MIRYHANG/srm-2027-minibot/README.md

# srm-2027-minibot

2027 校内赛抓取小车的控制程序。仓库里有两个工程：

- **小车主控**（仓库根目录）：STM32G474VET6，STM32Cube HAL、FreeRTOS（CMSIS-RTOS v1）、CMake
- **NRF24 手柄**（`Handheld/`）：STM32F103RC，裸机循环

两边共用的无线收发和手柄数据包代码放在 `Common/`。

以下内容按 2026-11-02 的 `power-on-debug` 分支整理。

## 当前进度

| 部分 | 状态 |
|---|---|
| 整车 | 2026-10-31 装上机械臂后整车联调通过，能正常行驶和操作机械臂 |
| 手柄 → NRF24 → 小车链路 | 实车联通：使能、换挡、摇杆、自转键都能控制小车 |
| 底盘四轮速度闭环 | 实车调过 PI 参数，四轮正常运行；行驶方向已按实车修正 |
| 机械臂 | 能用手柄点动；6 个舵机中 1 个烧毁，现有 5 个可用；预设姿态的角度是装机前的占位值，还没在实物上测量；关节零位、方向和限位还没标定 |
| 手机蓝牙遥控 | 代码保留，可编译切换，当前不用 |
| 电池电压、OLED 显示 | INA226 采样、欠压保护、OLED 显示已接入 |
| BMI088 姿态测量 | 已从板上拆下，驱动和航向保持代码已删除 |
| 电脑端单元测试 | 小车 17 组、手柄 1 组，全部通过 |

## 目录结构

| 目录 | 内容 |
|---|---|
| `Core/` | CubeMX 生成的启动、时钟、外设初始化；`app_freertos.c` 创建任务并把各模块串起来 |
| `BSP/` | 硬件封装：电机 PWM 与方向、编码器、舵机、INA226、SSD1306 OLED、I2C 总线、急停 |
| `Algorithm/` | 与硬件无关的计算：麦轮解算、PID |
| `Application/` | 整车逻辑：遥控输入与来源切换、使能和换挡、底盘指令换算、机械臂控制、电池监测、安全输入、任务心跳 |
| `Protocol/` | 手机蓝牙用的 SRM 串口协议：组帧、CRC、解码 |
| `Common/` | 小车和手柄共用：NRF24 驱动和链路层、手柄数据包 |
| `Handheld/` | 手柄工程，结构与小车相同（`Core/`、`Application/`、`Test/`） |
| `Test/` | 小车的电脑端单元测试 |
| `tools/` | 辅助脚本，目前有一键运行全部单元测试的脚本 |
| `docs/` | 架构说明、机械臂调用关系、调试日志 |
| `bringup/` | 早期单独验证 OLED 和电机用的小工程，不参与正式固件 |

## 小车软件结构

### 任务

| 任务 | 周期 | 优先级 | 职责 |
|---|---|---|---|
| `ProtocolTask` | 5 ms | AboveNormal | 收手柄和手机数据，读急停和欠压，处理使能和换挡，发布最新命令，回传状态给手柄 |
| `ChassisControlTask` | 10 ms | High | 麦轮解算、编码器测速、四轮速度 PI、输出 PWM；检查各任务心跳并喂看门狗 |
| `ArmTask` | 20 ms | Normal | 按命令点动或切换预设，限速逼近目标，换算成 6 路舵机脉宽 |
| `SensorTask` | 100 ms | Low | 读 INA226 电压电流、电池电量判断、刷新 OLED |

### 数据链路

```text
手柄摇杆和按键（每 10 ms 发一包，NRF24 2.500 GHz）
  → 小车 NRF24 接收，校验数据包
  → RemoteInput：选定遥控来源，超时 100 ms 判掉线
  → SafetyInput：急停、欠压
  → RobotCmd：使能锁存、换挡，生成底盘命令和机械臂命令
  ├→ ChassisDrive：按挡位换算四轮目标转速 → 编码器测速 → 速度 PI → TIM1 PWM 和方向引脚
  └→ ArmCycle：点动或预设 → 限位、限速 → 舵机脉宽 → TIM8 / TIM15
```

遥控来源在编译时选择：`Core/Src/app_freertos.c` 里的 `REMOTE_ACTIVE_SOURCE`，当前是 `REMOTE_SOURCE_HANDHELD`。改成 `REMOTE_SOURCE_PHONE` 就用手机蓝牙（USART2，9600 波特率，超时 200 ms）。

### 安全机制

- **使能要先失能再使能**：上电、急停解除或掉线恢复后，必须先收到一次"未使能"，再收到"使能"，小车才会动，防止手柄一直锁在使能状态时车自己跑起来。
- **掉线停车**：手柄超过 100 ms 没有有效数据包，底盘目标清零、PID 清零、PWM 归零；机械臂停在当前位置但保持出力。
- **硬件急停**：PE10 为低时整车失能。急停线同时接在四个驱动芯片的 nSLEEP 上，按下时驱动直接关断输出。
- **欠压保护**：3S 电池，单节低于 3.50 V（共 10.5 V）报警，低于 3.30 V（共 9.9 V）停车，带 0.1 V/节回差和 2 s 确认时间。
- **任务心跳和看门狗**：底盘任务确认其他三个任务都按时打了心跳才喂 IWDG，超时约 100 ms 整机复位。调试暂停时 IWDG 和 TIM1 冻结。
- **异常停机**：HardFault、`Error_Handler`、断言失败、栈溢出、内存分配失败都会直接关掉四路电机 PWM。
- **复位记录**：`g_reset_stats` 放在不初始化的 `.noinit` 段，按原因（引脚、欠压/上电、看门狗、软件）累计复位次数，在 Ozone 里能看到。

## 手柄操作

| 按键 | 作用 |
|---|---|
| START | 使能小车；同时把机械臂方向复位成正向、解除机械臂停止 |
| ESTOP | 失能小车，按下立刻生效 |
| 摇杆 | 前后、左右平移 |
| 摇杆按下 | 换挡 1 → 2 → 3 → 1，每次使能回到 1 挡 |
| CCW / CW | 按住时逆时针 / 顺时针自转 |
| J1～J5、GRIPPER | 按住时对应关节按当前方向点动 |
| ARM_DIR | 单按切换点动方向；按住时再按 J1 回收起姿态，按 J2 进入抓取准备姿态 |
| ARM_STOP | 只停机械臂，按 START 解除 |

解锁顺序：按一下 ESTOP 松开，再按 START。

| 指示灯 | 含义 |
|---|---|
| LED1 灭 / 慢闪 / 常亮 / 快闪 | 断连 / 已连上未使能 / 已使能 / 小车急停或驱动故障 |
| LED2 灭 / 常亮 / 快闪 | 机械臂正向 / 反向 / 已停止 |
| 两灯同时快闪 | 摇杆没标定好（上电时摇杆被推着）或 ADC 异常，手柄强制失能 |

## 硬件接口

### 小车主控

| 功能 | 外设 / 引脚 |
|---|---|
| 四路电机 PWM（20 kHz） | TIM1 CH1～CH4：FL PC0、FR PC1、RL PC2、RR PC3 |
| 四路电机方向 | FL PE2、FR PE3、RL PE4、RR PE5 |
| 四路驱动故障 nFAULT | FL PE12、FR PE13、RL PE14、RR PE15 |
| 编码器 | FL TIM4（PD12/PD13）、FR TIM3（PA6/PA4）、RL TIM2（PD3/PD4）、RR TIM5（PA0/PA1） |
| 六路舵机（50 Hz） | TIM8 CH1～CH4：PC6～PC9；TIM15 CH1/CH2：PB14、PB15 |
| NRF24 | SPI1：PB3 SCK、PB4 MISO、PB5 MOSI；PA10 CSN、PA11 CE、PE0 IRQ |
| 手机蓝牙 | USART2：PA2 TX、PA3 RX |
| OLED 和 INA226 | I2C2：PA8 SDA、PA9 SCL |
| 急停 | PE10，低电平有效 |
| 状态灯 | PE7 运行（500 ms 翻转）、PE8 已使能、PE9 安全故障 |
| 调试 | SWD：PA13、PA14 |

电机驱动为 DRV8873H，PH/EN 模式。BMI088 的片选和中断引脚在 CubeMX 里还保留着，没有使用。

### 手柄

| 功能 | 引脚 |
|---|---|
| 摇杆 X / Y | PA1 / PA2（ADC） |
| 摇杆按下 | PA9 |
| START / ESTOP | PC8 / PC9 |
| CCW / CW | PC6 / PC7 |
| ARM_DIR / ARM_STOP | PB0 / PB1 |
| J1～J5、GRIPPER | PB10～PB15 |
| LED1 / LED2 | PB7 / PB6 |
| NRF24 | SPI1：PA5 SCK、PA6 MISO、PA7 MOSI；PA4 CSN、PA8 CE、PB8 IRQ |

## 实车参数

| 参数 | 值 | 位置 |
|---|---|---|
| 编码器每圈计数 | 1321（输出轴，实测） | `BSP/encoder.h` |
| 编码器方向 | FL -1、FR 1、RL 1、RR -1 | `BSP/encoder.h` |
| 电机方向 | FL 1、FR -1、RL -1、RR 1 | `Core/Src/app_freertos.c`，`Motor_InitAndStart` |
| 速度 PI | FL、FR：Kp 0.016、Ki 0.04；RL、RR：Kp 0.02、Ki 0.04；输出限幅 1.0 | `Core/Src/app_freertos.c`，`SpeedPID_InitAll` |
| 挡位最大轮速 | 200 / 250 / 300 rpm | `Application/chassis_drive.h` |
| 关节限位 | J1～J5 均为 0～180°，对应 500～2500 µs | `Application/arm_calib.c` |
| 夹爪 | 0（张开）～1（闭合），对应 1000～2000 µs | `Application/arm_calib.c` |
| 关节点动速度 | 60°/s，夹爪 0.5/s | `Application/arm_calib.c` |
| 收起姿态（上电位置） | J1～J5：90、30、30、90、90°，夹爪张开（占位值，未实测） | `Application/arm_control.c` |
| 抓取准备姿态 | J1～J5：90、60、120、135、90°，夹爪张开（占位值，未实测） | `Application/arm_control.c` |
| NRF24 信道 | 100（2.500 GHz） | `Common/NRF24/nrf_link.h` |

## 临时措施与已知问题

以下是为了先让车动起来而做的临时处理，硬件改好后要恢复。

1. **驱动故障检测被屏蔽。** DRV8873H 的 nOL 引脚接了地，会打开运行中的开路检测；电机电流或占空比小时会误报并锁住 nFAULT，但 H 桥照常输出。误报会让整车失能，所以 `MOTOR_FAULT_IGNORE_MASK` 暂时屏蔽了四路 nFAULT。过流和过热仍由驱动芯片自己关断。
   - 硬件改法：四个驱动的 nOL 改接 DVDD。
   - 改好后把 `MOTOR_FAULT_IGNORE_MASK` 改回 `0U`。
2. **机械臂限位暂时放开到 0～180°**，方便实物标定。标定出各关节真实的机械范围后要收回来，否则可能顶坏结构。
3. **驱动芯片损坏过**：10-30 FL 驱动芯片损坏，FL 电机不受控狂转，已更换新芯片，现在四轮正常。调试中 RR 也出现过程序没运行时电机自转的现象。驱动先后出问题，可能是电机刹车时反电动势把 VM 冲高，建议每个驱动旁加 100～470 µF 电解电容。
4. **舵机堵转导致复位和烧毁**：10-31 六个舵机一起上电，几个舵机堵转把主控拉复位，一个舵机烧毁。更换全部降压电路后恢复正常。
   - 原因：上电时 6 个舵机会同时全速转到收起姿态。这组角度是装机前填的占位值，可能让机械臂顶到结构上而堵转。
   - 建议：先在实物上量出收起姿态的角度，写进代码；舵机单独用一路大电流降压供电，并在舵机电源上加大电容。
5. **接 J-Link 时会复位**：Ozone 下载、复位或两个程序同时连 J-Link 都会让主控复位；装上机械臂后，J-Link 接着一段时间也会复位（J-Link 没有接 3.3V）。拔掉 J-Link 后实测 5 分钟没有复位。因为这个问题，预设姿态还没法在 Ozone 里看着舵机角度实测。
   - 复位脚现在飞线接到了 3.3V。如果中间没有串电阻，按复位键会直接把 3.3V 对地短路，看门狗和 J-Link 也拉不低复位脚。建议改成 10 kΩ 上拉到 3.3V，再并 100 nF 电容到地。
6. **电机噪声**：速度环每 10 ms 测一次速，多数或少数一个编码器计数，测出的转速就差约 4.5 rpm，速度环输出会小幅来回跳动。可以加大测速滤波或给误差加死区，还没改。

## 构建、烧录和测试

需要 `arm-none-eabi-gcc`、CMake、Ninja；测试需要电脑上的 `gcc`。

```bash
# 小车固件，产物 build/Debug/XiaoSai.elf
cmake --preset Debug
cmake --build build/Debug

# 手柄固件，产物 Handheld/build/Debug/XiaoSai_NRF.elf
cd Handheld
cmake --preset Debug
cmake --build build/Debug

# 电脑端单元测试（仓库根目录运行）
bash tools/run_host_tests.sh
```

烧录和调试用 J-Link + SEGGER Ozone，直接打开 `XiaoSai.jdebug`（小车）或 `Handheld/XiaoSai_NRF.jdebug`（手柄）。工程里预置了常用观察变量，按 10 Hz 实时刷新。这个 J-Link 不支持高速采样，Data Sampling 用不了，看波形要用 Watched Data。

修改引脚、定时器等外设配置时，以 `XiaoSai.ioc` / `Handheld/XiaoSai_NRF.ioc` 为准，用 CubeMX 重新生成；自己写的代码放在 USER CODE 区或独立模块里。

## 文档

| 文档 | 内容 |
|---|---|
| `docs/小车工程架构说明.md` | 2026-10-03 时的整体架构，部分内容已过时，以本 README 为准 |
| `docs/机械臂代码调用关系.md` | 机械臂各模块的调用关系、数据结构和安全机制 |
| `docs/调试日志.md` | 电脑端测试和固件构建记录 |
| `docs/上电调试日志.md` | 实车上电调试记录 |
| `RM校内赛机械臂设计手册.docx` | 结构组给出的机械臂设计手册 |

## 历史开发记录

以下保留当时的记录，内容已过时，最新状态以上文为准。完整修改过程见 `git log`。

### 2026-09-28

#### 今日完成

以下条目表示代码或配置已实现，不代表已经通过硬件验证

- [x] 完成当前引脚调整：SPI1 使用 PB3/PB4/PB5，I2C 从 I2C1 切换为 I2C2，使用 PA8 SDA 和 PA9 SCL
- [x] 将 BMI088 加速度计、陀螺仪片选移至 PC10、PC11，并将初始电平设为 High
- [x] 配置六路舵机 PWM：TIM8 的 PC6～PC9，以及 TIM15 的 PB14/PB15，当前频率为 50 Hz
- [x] 开启 USART2 中断，抢占优先级设为 5，与当前 FreeRTOS 中断 API 使用要求匹配
- [x] 实现 `RemotePhone_ProcessByte()`：逐字节组帧、CRC 校验、CONTROL 解码、命令转换和手机状态更新
- [x] 实现 `remote_uart` 接收模块：创建队列、启动单字节中断接收、保存接收时间、入队和非阻塞出队
- [x] 实现接收异常标记、错误回调及任务侧恢复，恢复时停止接收、丢弃缓存并重新启动
- [x] 实现 `PhoneRemote_InitAndStart()` 和 `PhoneRemote_Update()`，接入现有底盘周期任务
- [x] 实现 `Chassis_UpdateFromRemote()`，将归一化遥控量转换为底盘速度，再计算四轮目标 RPM

#### 当前数据链路

```text
USART2 接收一个字节
  → 中断回调将字节和接收时间放入队列
  → 底盘任务按处理预算取出字节
  → RemotePhone_ProcessByte 拼帧、校验、解码和转换
  → RemoteInput 保存手机命令和有效帧时间
  → RemoteInput_GetSafe 检查来源、超时、使能和停机请求
  → Chassis_UpdateFromRemote 换算底盘速度
  → 麦轮解算得到四轮目标 RPM
  → 编码器测速与 PID 计算
```

- 中断只接收和暂存数据，协议解析与遥控状态修改由同一个底盘任务完成
- 队列容量为 64 个接收记录，每个记录包含一个字节和毫秒时间戳
- 每个任务周期最多处理 64 个字节，不是 64 帧
- 时间戳使用字节接收回调中的 `HAL_GetTick()`，不是任务稍后处理字节的时间
- 只有完整有效的控制帧才会更新 `last_valid_ms`
- 掉线、未使能、停机请求或接收异常时，当前安全遥控命令归零
- 接收异常时清空手机旧状态并重置解析器，恢复后必须等待新的有效帧

#### 当前运行限制

- 底盘任务周期为 10 个 RTOS tick，当前 tick 频率为 1000 Hz，对应约 10 ms
- 底盘尺寸、速度上限和 PID 增益仍为零占位，不产生正常运动目标
- `WheelSpeed_Update()` 目前只计算 PID，尚未将输出交给 `Motor_SetOutput()`
- `Chassis_Stop()` 尚未实现，目标 RPM 归零不能代替实际 PWM 停机与 PID 状态清理
- 手机无线串口模块到小车的真实链路、四轮闭环及六路舵机均未完成实物联调
- 今日新增接收与任务链路尚未记录编译、上板运行及异常注入测试结果

#### 当前主要引脚

以当前 `XiaoSai.ioc` 配置为准，轮位标签与程序实例绑定仍需核对

| 功能 | 外设 / 引脚 |
|---|---|
| 四路电机 PWM | TIM1 CH1～CH4：PC0、PC1、PC2、PC3 |
| 四路电机方向 | FL/FR/RL/RR：PE2、PE3、PE4、PE5 |
| 编码器 TIM2 | PD3、PD4 |
| 编码器 TIM3 | PA6、PA4 |
| 编码器 TIM4 | PD12、PD13 |
| 编码器 TIM5 | PA0、PA1 |
| 六路舵机 PWM | TIM8：PC6～PC9；TIM15：PB14、PB15 |
| SPI1 | PB3 SCK、PB4 MISO、PB5 MOSI |
| BMI088 片选 | PC10 ACC_CS、PC11 GYRO_CS，初始 High |
| NRF24 控制 | PA10 CSN，初始 High；PA11 CE，初始 Low |
| I2C2 | PA8 SDA、PA9 SCL |
| USART2 | PA2 TX、PA3 RX |
| SWD | PA13、PA14 |

#### 参数待办

| 参数 | 当前设置 | 待确认事项 |
|---|---|---|
| 轮半径、轴距、轮距 | 均为 `0.0f` | 实测并填写，单位为米 |
| 编码器每圈计数 | `COUNT_PER_REV = 10` | 确认输出轴每圈实际定时器计数，包含编码器倍频和减速比影响 |
| 编码器方向 | 四轮统一使用 `DIRECTION_SIGN = -1` | 根据轮位和接线逐轮验证 |
| 电机方向 | 四轮初始化均为 `+1` | 逐轮确认正转与编码器正方向一致 |
| 测速滤波时间常数 | `0.01 s` | 根据测速噪声与响应调整 |
| PID 增益 | `Kp/Ki/Kd` 均为零 | 上板后逐轮调试，当前输出限幅为 `1.0` |
| 前后 / 横移速度上限 | 均为 `0.0 m/s` | 根据底盘能力设置保守上限并验证 |
| 旋转角速度上限 | `0.0 rad/s` | 根据底盘能力设置并验证 |
| 手机遥控超时 | `200 ms` | 根据实际发送周期和链路延迟确认 |
| USART2 波特率 | `9600` | 与手机无线串口模块的串口侧配置一致 |
| 舵机控制参数 | 仅配置 50 Hz PWM | 确认舵机型号、脉宽范围、零位、角度限位及动作速度 |
| 电源监测参数 | 尚未实现 | 确认分流电阻、INA226 校准、电池容量及保护阈值 |

#### 后续任务

- [ ] 核对编码器轮位标签与程序绑定：当前 IOC 的 FL 标签在 TIM4、RL 标签在 TIM2，但 `Encoder_InitAndStart()` 将 FL 绑定到 TIM2、RL 绑定到 TIM4，需按实际接线统一
- [ ] 实现 `Chassis_Stop()`：四轮目标归零、PWM 输出归零、清理 PID 动态状态
- [ ] 将 PID 输出接入电机驱动，补充参数有效性检查及四轮目标 RPM 限幅
- [ ] 完成六路舵机驱动、脉宽及角度限位、手动抓取控制和抓取 / 运输 / 交接动作
- [ ] 完成自制手柄的摇杆与按键采集、发送程序，以及小车端 NRF24 收发驱动
- [ ] 完成 INA226 电压、电流和功率采集，以及 OLED 显示和电量估算
- [ ] 完成电源异常保护、全车停机与恢复策略，以及共享 SPI 设备的访问管理
- [ ] 补充协议拆包、粘包、CRC 错误、超时、切换来源、队列溢出和串口错误恢复测试
- [ ] 完成底盘、抓取机构及无线链路的实物联调，记录实际参数、测试结果和调试日志
- [ ] 核对借鉴代码的许可证要求，保留来源和作者信息

### 2026-09-27

- 完成遥控输入管理：分别保存手机和手柄命令，支持切换来源；无有效帧、命令超时、未使能或请求停机时，返回零命令。
- 添加遥控输入的电脑端基本测试，覆盖初始化、保存命令和读取命令。
- 将 SRM 遥控协议解析代码加入工程，支持逐字节组帧、CRC 校验及 CONTROL 消息解码。
- 实现 `RemotePhone_Convert()`：检查摇杆原始值，将左摇杆 Y/X、右摇杆 X 转换为前后、左右、旋转命令，并读取 S1 使能和 S2 停机状态。
- 在 CubeMX 中配置 USART2、SPI1、I2C1 和六路舵机 PWM；配置 BMI088 片选及 NRF24L01 的 CSN、CE 引脚。SPI1 时钟已调整为约 5.31 MHz，TIM8 和 TIM15 已调整为 50 Hz。

截至 2026-09-27，手机遥控命令尚未通过 USART2 接收到 STM32，底盘任务仍使用零速度指令；外设也尚未进行实物联调。

#### 当日后续计划

以下保留当日记录，最新代码进展与待办见 2026-09-28 开发记录

- [ ] 实现 USART2 接收，将收到的字节送入协议解析器。
- [ ] 完整且校验通过的 CONTROL 帧，经过 `RemotePhone_Convert()` 后更新到 `RemoteInput`。
- [ ] 在底盘任务中读取安全遥控命令，替换当前固定的零速度指令。
- [ ] 补充超时、停机、切换来源和错误帧测试。
- [ ] 核对所借鉴协议代码的许可证要求。
