MIRYHANG/srm-2027-minibot/docs/调试日志.md

# 纯软件调试日志

## 2026-10-03 四项主机逻辑测试

测试环境：Windows PowerShell、GCC，均在项目根目录编译并运行。测试程序的输出文件放在被 `.gitignore` 忽略的 `build/` 目录中。本次没有连接 STM32、小车底盘或舵机。

| 测试 | 验证内容 | 结果 |
| --- | --- | --- |
| `test_mecanum` | 麦轮前进、左移、旋转解算，以及无效轮半径时的零输出 | 通过 |
| `test_remote_input` | 遥控状态初始化、选择手机来源、保存有效命令、读取安全命令 | 通过 |
| `test_arm_calib` | 标定表不变量、脉宽插值与四舍五入、反向映射、越界及无穷值裁剪、NaN 和非法参数拒绝 | 通过 |
| `test_arm_motion` | 限速单步移动、精确到达、正反向移动、限位裁剪、已到达保持、原地输出、非法输入失败时不改输出 | 通过 |

### 复现命令

```powershell
gcc -std=c11 -Wall -Wextra -IAlgorithm Test/test_mecanum.c Algorithm/mecanum.c -o build/test_mecanum.exe -lm
.\build\test_mecanum.exe

gcc -std=c11 -Wall -Wextra -IApplication Test/test_remote_input.c Application/remote_input.c -o build/test_remote_input.exe -lm
.\build\test_remote_input.exe

gcc -std=c11 -Wall -Wextra -IApplication Test/test_arm_calib.c Application/arm_calib.c -o build/test_arm_calib.exe -lm
.\build\test_arm_calib.exe

gcc -std=c11 -Wall -Wextra -Wconversion -IApplication Test/test_arm_motion.c Application/arm_motion.c Application/arm_calib.c Application/arm_pose.c -o build/test_arm_motion.exe -lm
.\build\test_arm_motion.exe
```

### 实际结果

四个程序均以退出码 0 正常结束。`test_mecanum`、`test_arm_calib`、`test_arm_motion` 分别打印 `Mecanum tests passed`、`Arm calibration tests passed`、`Arm motion tests passed`；`test_remote_input` 没有打印文字，以退出码 0 表示通过。上述编译命令未输出警告。本次结果说明这些测试覆盖的纯逻辑场景通过，不代表串口无线链路、电机、编码器或舵机已经完成实物验证；本次也未运行 STM32 固件构建。

## 2026-10-04 手机遥控命令映射测试

测试文件：`Test/test_remote_phone.c`

测试范围：手机 CONTROL 状态转换、机械臂关节选择、按钮映射，以及完整数据帧解析到安全遥控命令的处理流程

覆盖内容：

1. 右摇杆 Y 仅作用于选中关节，检查 -512、511 和零输入
2. 上键连续按住三帧只切换一次，松开再按可再次切换
3. 上下切换在 J1 和夹爪之间正确回绕
4. 左右方向键分别输出 turn = +1、-1，中心为零，右摇杆 X 不影响自转
5. A/B 预设映射、A+B 冲突处理，以及 X/Y 夹爪请求
6. S1/S2 对使能和停机标志的映射
7. 非法轴值、方向键和按钮位被拒绝，输出清零，选中关节和方向键历史不变
8. 空指针和非法关节编号被拒绝
9. 使用 srm_build_control 组帧并逐字节输入，先发送 S1=0 完成重新上锁，再发送 S1=1，检查安全输出的全部字段

### 编译与运行

在项目根目录执行，使用 assert 检查，不添加 -DNDEBUG：

```powershell
gcc -std=c11 -Wall -Wextra -Wconversion -IApplication -IProtocol Test/test_remote_phone.c Application/remote_phone.c Application/remote_input.c Application/arm_pose.c Application/arm_calib.c Protocol/srm_protocol.c -o build/test_remote_phone.exe -lm
if ($LASTEXITCODE -eq 0) {
    .\build\test_remote_phone.exe
}
```

### 实际结果

待运行

通过标准：编译无警告，程序退出码为 0，并打印：

```text
Remote phone tests passed
```

本测试验证主机端纯逻辑，不代表手机无线链路或机械臂硬件已经通过实物测试

## 2026-10-04 任务 5A：协议任务迁移与任务心跳监测

变更内容：

- 手机解析和遥控状态仅由 ProtocolTask 管理
- ProtocolTask 每 5 ms 通过长度 1 队列覆盖发布安全命令
- 底盘和机械臂使用 xQueuePeek 读取，发布超过 30 ms 时返回全零
- 底盘任务仅在协议、机械臂和传感器任务均未超时时喂狗
- 三个任务心跳期限分别为 30、100、400 ms
- 机械臂和传感器任务仅搭建周期与心跳框架

### 主机测试

在工程根目录 PowerShell 中执行以下脚本
编译或测试失败时抛出错误，不继续运行旧的可执行文件

```powershell
function Invoke-HostLogicTest {
    param(
        [string]$Name,
        [string[]]$Sources
    )

    $testExe = ".\build\$Name.exe"

    & gcc -std=c11 -Wall -Wextra -Wconversion `
        -IApplication -IProtocol -IAlgorithm `
        @Sources -o $testExe -lm

    if ($LASTEXITCODE -ne 0) {
        throw "$Name 编译失败"
    }

    & $testExe

    if ($LASTEXITCODE -ne 0) {
        throw "$Name 测试失败"
    }
}

Invoke-HostLogicTest -Name "test_task_monitor" -Sources @(
    "Test/test_task_monitor.c",
    "Application/task_monitor.c"
)

Invoke-HostLogicTest -Name "test_arm_calib" -Sources @(
    "Test/test_arm_calib.c",
    "Application/arm_calib.c"
)

Invoke-HostLogicTest -Name "test_arm_motion" -Sources @(
    "Test/test_arm_motion.c",
    "Application/arm_motion.c",
    "Application/arm_calib.c",
    "Application/arm_pose.c"
)

Invoke-HostLogicTest -Name "test_mecanum" -Sources @(
    "Test/test_mecanum.c",
    "Algorithm/mecanum.c"
)

Invoke-HostLogicTest -Name "test_remote_input" -Sources @(
    "Test/test_remote_input.c",
    "Application/remote_input.c"
)

Invoke-HostLogicTest -Name "test_remote_phone" -Sources @(
    "Test/test_remote_phone.c",
    "Application/remote_phone.c",
    "Application/remote_input.c",
    "Application/arm_pose.c",
    "Application/arm_calib.c",
    "Protocol/srm_protocol.c"
)
```

需同时检查编译输出没有 warning，仅退出码为 0 不代表零警告

### 固件构建

```powershell
cmake --build build/Debug
```

### 实际结果

| 项目 | 结果 |
| --- |---|
| test_task_monitor | pass |
| test_arm_calib | pass |
| test_arm_motion | pass |
| test_mecanum | pass |
| test_remote_input | pass |
| test_remote_phone | pass |
| 固件构建及零警告检查 | pass |
| RAM 占用 | 15.45% |
| FLASH 占用 | 9.41% |

新测试通过时打印 `Task monitor tests passed`

主机测试验证心跳时间计算逻辑，不验证实际任务调度、队列并发行为和 IWDG 硬件复位

## 2026-10-05 

- 改动：任务心跳超时后底盘立即停车，不再按遥控命令继续运动；删掉 PhoneRemote_Update 里重复的 return
- 构建：cmake --build build/Debug，零警告，RAM 15.45%，FLASH 9.41%
- 主机测试：6 个全部通过

## 2026-10-05 任务 4：ArmControl_Update

- 改动：新增 ArmControl_GetPreset、ArmControl_Update；arm_pose.h 增加夹爪约定（0.0 张开，1.0 夹紧）；新增 Test/test_arm_control.c
- 设计：jog 以当前位姿为基准，松手即停；首次更新以当前位姿为目标；预设只改 J1～J5，夹爪只由 X/Y 控制；非法输入返回 false，control 不变
- 构建：cmake --build build/Debug，零警告，RAM 15.45%，FLASH 9.41%（新函数尚未被固件调用，链接时被丢弃）
- 主机测试：7 个全部通过，arm_control.c 行覆盖率 95.8%
- 待实物：预设位姿占位值需实测；预设动作各关节独立运动，需确认途中不碰撞

## 2026-10-05 任务 5B：ArmTask 接上舵机输出

- 改动：新增 Application/arm_cycle（纯逻辑：更新目标 → 限速逼近 → 换算脉宽）和 Test/test_arm_cycle.c；ArmTask 上电先以 STOW 算好 6 路脉宽再启动 PWM，每 20 ms 执行一次 ArmCycle_Step；main 上电读取复位标志 g_reset_flags
- 设计：未使能、停机或遥控失联时目标拉回当前位置，机械臂当场停住但不卸力，恢复后预设不会自动继续；任一步失败保持上一次脉宽，不停 PWM、不输出 0；dt 超过 0.06 s 按 0.06 s 计算
- 构建：cmake --build build/Debug，零警告，RAM 15.49%，FLASH 10.14%（任务 4 的函数开始被调用，FLASH 增加约 3.8 KB）
- 主机测试：8 个全部通过，arm_cycle.c 行覆盖率 82.5%
- 待实物：servo_1～6 与关节的对应关系需和机械组确认；示波器确认上电即输出 STOW 脉宽；失联、S2 停机时机械臂停住不掉；看门狗复位后检查 g_reset_flags 的 IWDGRSTF；检查 ArmTask 栈余量
- 已知风险：上电或看门狗复位后机械臂会全速冲向 STOW（无位置反馈），STOW 需选低位、收拢、不会撞到东西的姿态

## 2026-10-05 任务 1A：INA226 功率采样

- 改动：新增 BSP/i2c_bus.h（I2C 读写接口）、BSP/i2c_bus_hal（HAL 实现，单次超时 10 ms）、BSP/ina226（芯片驱动）和 Test/test_ina226.c；SensorTask 每 100 ms 调用 PowerSensor_Update
- 设计：上电读厂商 ID 0x5449 和芯片 ID 0x2260 确认芯片；优先地址 0x40，找不到时扫描 0x40～0x4F；配置 0x4527（16 次平均、1.1 ms 转换、连续测量）并回读校验；电流由分流电压除以 2 mΩ 在软件里计算，量程约 ±40.96 A，分辨率 1.25 mA；读取失败每 1 s 重试一次，不进入 Error_Handler，不影响行驶
- 构建：cmake --build build/Debug，零警告，RAM 15.54%，FLASH 10.94%
- 主机测试：9 个全部通过，ina226.c 行覆盖率 98.5%（新测试编译需加 -IBSP）
- 待实物：调试器查看 power_sensor.addr / ready；万用表对比 power_reading.bus_v；电机转动时 current_a 应为正，否则 IN+ / IN- 接反；拔插 SDA 验证 1 s 内自动恢复；分流电阻需 1 W 以上封装

## 2026-10-05 任务 1B：SSD1306 OLED 功率显示

- 改动：新增 BSP/font5x7（空格到 Z 的 5×7 字库）、BSP/ssd1306（驱动）、Application/power_display（显示格式化）和两个测试；SensorTask 每 500 ms 调用 Oled_Update；I2C2 改为 400 kHz（提交 8ad1564）
- 设计：只刷新内容变化的页，每次 I2C 传输 16 字节（避免超过 10 ms 超时）；数值格式化不用 printf（newlib-nano 不支持 %f）；读数无效显示横线和 INA226 ERROR；最后一行显示复位原因；显存为静态变量；屏幕故障每 1 s 重试，不影响行驶
- 显示内容：XIAOSAI POWER / U 电压 / I 电流 / P 功率 / INA226 状态 / RST 复位原因
- 构建：cmake --build build/Debug，零警告，RAM 16.48%，FLASH 11.51%
- 主机测试：11 个全部通过，ssd1306.c、font5x7.c、power_display.c 行覆盖率均为 100%
- 待实物：确认 OLED 地址（0x3C / 0x3D）；字左右或上下颠倒时改 ssd1306.c 里的 0xA1 / 0xC8；拔插 OLED 和 INA226 验证自动恢复；看门狗复位后应显示 RST IWDG
