MIRYHANG/srm-2027-minibot/bringup/TestMotor/docs/调试日志.md

# 电机测试工程调试日志

## 2026-10-05 工程说明

- 用途：单独测试四个电机的转向、接线对应关系和编码器，不经过遥控、PID 和任务心跳
- 来源：`XiaoSai.ioc` 与主工程逐字节相同；`BSP/motor`、`BSP/encoder`、`BSP/safety` 从主工程复制，未修改
- 入口：`main.c` 在 `MX_IWDG_Init()` 之后调用 `MotorTest_Run()`，不启动 RTOS，永不返回
- 构建：`cmake --preset Debug` 后执行 `cmake --build build/Debug`，零警告，RAM 14.93%，FLASH 6.63%
- 实物验证：尚未进行

## 运行方式

- 自动模式（默认，`MOTOR_TEST_AUTO 1`）：上电即开始转。四个电机按 FL → FR → RL → RR 轮流执行 正转 1 s → 停 1 s → 反转 1 s → 停 1 s，占空比 15%，一轮 16 s，循环执行
- 手动模式（`MOTOR_TEST_AUTO 0`）：上电不转。调试器暂停后修改 `g_motor_duty`，继续运行即生效
- 占空比在两种模式下都限制在 ±0.3
- 电机方向修正一律为 +1，看到的是原始转向；编码器沿用主工程的 `COUNT_PER_REV = 10`、`DIRECTION_SIGN = -1`
- 停止方法只有三种：断电、调试器暂停（TIM1 冻结后输出关闭）、手动模式下把占空比改回 0。没有遥控急停

## LED

| LED | 引脚 | 含义 |
| --- | --- | --- |
| LED_RUN | PE7 | 每 0.5 s 翻转一次，表示程序在运行 |
| LED_LINK | PE8 | 任一电机有输出时点亮 |

## 调试变量

数组下标顺序统一为 FL、FR、RL、RR

| 变量 | 类型 | 读写 | 含义 | 用法 |
| --- | --- | --- | --- | --- |
| `g_motor_duty[4]` | float | 手动模式可改 | 当前输出占空比，范围 ±0.3 | 手动模式下暂停后修改；自动模式下每周期被覆盖 |
| `g_auto_step` | uint32_t | 只读 | 自动模式步骤：0～3 FL，4～7 FR，8～11 RL，12～15 RR；每个电机内 0 正转、1 停、2 反转、3 停 | 核对正在转的是否是对应的轮子 |
| `g_fwd_delta[4]` | int32_t | 只读 | 最近一次正转 1 s 期间的编码器计数变化 | 跑完一轮 16 s 后一次性读取，判断编码器方向、断线和接错位 |
| `g_rev_delta[4]` | int32_t | 只读 | 最近一次反转 1 s 期间的编码器计数变化 | 符号应与 `g_fwd_delta` 相反，绝对值接近 |
| `g_encoder_count[4]` | int32_t | 只读 | 编码器累计计数，已乘 `DIRECTION_SIGN` | 断开电机电源后用手转轮子，看对应项是否变化；向前转整 1 圈得到的绝对值即每圈实际计数 |
| `g_driver_fault[4]` | uint8_t | 只读 | 驱动 FAULT 引脚原始电平，输入上拉 | 有效电平以驱动手册为准；正常运转时应保持不变 |

### 判断方法

| 现象 | 结论 | 主工程中的修改 |
| --- | --- | --- |
| 正转时轮子朝车后退方向转 | 电机方向反 | 该轮 `Motor_Init` 最后一个参数改为 -1 |
| 电机方向正确，但 `g_fwd_delta` 为负 | 编码器方向与当前 `DIRECTION_SIGN` 不符 | 该轮编码器方向修正取反（需改为每轮单独配置） |
| `g_fwd_delta` 接近 0 | 编码器未接好、未供电或线接错位 | 检查接线 |
| 转的是 A 轮，变化的却是 B 轮的计数 | 编码器接错位 | 按实际接线核对定时器绑定 |
| `g_fwd_delta` 与 `g_rev_delta` 绝对值相差很大 | 机械阻力不对称或驱动异常 | 检查机械和驱动 |

## 测试记录

测试条件：轮子架空；电源电压 ____ V，限流 ____ A

| 轮位 | 是否为对应轮子 | 正转方向（前 / 后） | `g_fwd_delta` | `g_rev_delta` | 手转 1 圈计数 | `g_driver_fault` | 结论 |
| --- | --- | --- | --- | --- | --- | --- | --- |
| FL |  |  |  |  |  |  |  |
| FR |  |  |  |  |  |  |  |
| RL |  |  |  |  |  |  |  |
| RR |  |  |  |  |  |  |  |

需要回填主工程的结果：

- 电机方向修正（FL / FR / RL / RR）：
- 编码器方向修正（FL / FR / RL / RR）：
- 每圈实际计数 `COUNT_PER_REV`：
- 驱动 FAULT 有效电平：
