MIRYHANG/srm-2027-minibot/Ozone调试变量清单.docx

Ozone 上电调试变量清单

适用工程：小车 build/Debug/XiaoSai.elf（STM32G474）、手柄 Handheld/build/Debug/XiaoSai_NRF.elf（STM32F103RC）　|　2026-10-27

# 1 使用方法

## Watched Data 与 Data Sampling 的区别

- Watched Data：显示变量的当前值，可以展开结构体和数组。适合看状态标志、开关量和结构体。
- Data Sampling：按采样频率连续记录数值，Setup 页显示最小、最大和平均值，Samples 和 Timeline 页可以看曲线。只支持数值，结构体要写到具体字段，例如 encode_fl.speed_rpm；数组要一个元素一个元素地加，例如 arm_cycle.pulse_us[0]。

## 添加变量

- Watched Data：在源码里右键变量名，选 Add to Watched Data；或者直接在窗口最下面一行输入表达式。
- Data Sampling：菜单 View 打开 Data Sampling 窗口，在 Setup 页最下面一行输入表达式。采样频率选 1 kHz 即可。
- 窗口太窄时 Value 列会被挤掉，把窗口拖宽就能看到数值。

## 连接注意

- 用 Debug → Attach to Running Program 连接，不要点 Reset 或 Download，否则看到的是刚上电的状态。
- 小车和手柄各用自己的 Ozone 工程（不同的 elf 文件）。两边都有 radio_ready，含义分别是各自的 NRF 是否配置成功。
- 插拔 NRF 模块一律先断电，按插座旁标记的方向插，插好后先摸一下是否发热。

# 2 小车（XiaoSai.elf）

## 2.1 Watched Data

分组 | 表达式 | 含义 | 正常值
系统 | reset_cause | 上次复位原因：1 上电，2 复位键或调试器，3 软件，4 看门狗 | 不能是 4
| g_reset_flags | 复位标志原始值（RCC_CSR） | 含 0x20000000 表示看门狗复位
安全与使能 | safety_input.active | 安全条件：0x01～0x08 驱动故障，0x10 急停，0x20 欠压 | 0
| robot_cmd.enabled | 整车是否已使能 | 先失能再使能后为 1
| robot_cmd.seen_disable | 失能后是否收到过一帧“未使能” | 使能前须为 1
| robot_cmd.gear | 当前挡位 | 1～3
电源 | power_reading_valid | INA226 读数是否有效 | 1
| battery_level | 电池状态：0 未知，1 正常，2 低压，3 欠压停机 | 1
遥控来源 | remote_input.selected | 当前遥控来源：1 手机，2 手柄 | 与 REMOTE_ACTIVE_SOURCE 一致
手机蓝牙 | remote_input.phone.has_valid_frame | 收到过有效帧 | 1
| remote_input.phone.last_valid_ms | 最近一帧有效数据的时间，与 uwTick 对比 | 相差小于 200
| remote_input.phone.armed | 收到过 S1 关闭的帧（重新上锁） | 1
| remote_input.phone.command | 展开查看：enabled（S1）、stop_requested（S2）、forward 等 | 随手机操作变化
手柄 NRF | radio_ready | 小车 NRF 配置成功 | 1
| remote_input.handheld.has_valid_frame | 收到过手柄有效包 | 1
| remote_input.handheld.armed | 收到过手柄失能包（重新上锁） | 1
| remote_input.handheld.command | 展开查看手柄命令 | 随手柄操作变化
IMU | bmi088.ready | BMI088 初始化成功 | 1
| imu_yaw.calibrated | 零偏标定完成（上电静止约 2 s） | 1
| imu_yaw.bias_dps | 陀螺仪零偏，单位 °/s | 绝对值较小且稳定
| heading_hold.locked | 航向是否已锁定 | 停止自转约 0.3 s 后为 1
机械臂 | arm_cycle.initialized | 机械臂控制已初始化 | 1
| arm_cycle.control.target | 展开查看各关节目标角度 | 随遥控变化
诊断（未提交） | remote_diag | 展开查看 OLED 第 2 行的遥控诊断内容 | 字段含义同 OLED 的 R/F/S/X/E

## 2.2 Data Sampling

分组 | 表达式 | 看什么
系统 | uwTick | 系统时间（ms）。曲线突然回落说明发生了复位
遥控计数 | phone_rx_bytes | 手机串口收到的字节数（未提交代码），应持续上升
| phone_rx_frames | 手机有效帧数（未提交代码）。字节涨、帧不涨说明波特率或协议不对
| radio_rx_count | 手柄包计数，应持续上升
| radio_bad_count | 校验失败的手柄包，应基本不涨
机械臂 | arm_cycle.current.joint[0] | J1 当前角度（命令值，非实测），[1]～[4] 为 J2～J5，[5] 为夹爪 0～1
| arm_cycle.control.target.joint[0] | J1 目标角度，与 current 对比可看限速逼近过程
| arm_cycle.pulse_us[0] | J1 输出脉宽（μs），[1]～[5] 同理
底盘（每个轮子各加一组，fl/fr/rl/rr） | target_rpm_fl | 左前轮目标转速
| encode_fl.speed_rpm | 左前轮实测转速，与目标转速放在同一张图对比
| speed_pid_fl.Output | 左前轮 PID 输出，范围 -1～1
| encode_fl.total_count | 编码器累计计数，手转一圈看增量，用来标定 COUNT_PER_REV
IMU | imu_yaw.rate_dps | 角速度（°/s），逆时针为正。手动逆时针转车应为正
| imu_yaw.yaw_deg | 航向角（°），静止时漂移应很小
| heading_hold.target_deg | 锁定的目标航向
电源 | power_reading.bus_v | 母线电压（V）
| power_reading.current_a | 总电流（A），电机转动时应为正
| power_reading.power_w | 功率（W）
| battery_monitor.filtered_v | 滤波后的电池电压，判断欠压用

底盘四个轮子的变量名把 fl 依次换成 fr、rl、rr；同一个轮子的目标转速、实测转速、PID 输出放在一起看。机械臂各关节把下标 [0] 换成 [1]～[5]。

# 3 手柄（XiaoSai_NRF.elf）

## 3.1 Watched Data

分组 | 表达式 | 含义 | 正常值
输入 | calibrated | 摇杆中点标定完成（上电时不要推摇杆） | 1
| input_ok | ADC 读数正常 | 1
NRF | radio_ready | 手柄 NRF 配置成功 | 1
| spi_fault | SPI 通信出错 | 0
| have_status | 收到小车回传的状态（链路通） | 1
| car_status.flags | 小车状态：bit0 已使能，bit1 急停或驱动故障 | 使能后为 1
| car_status.gear | 小车当前挡位 | 1～3
逻辑 | logic.enabled | 手柄端使能锁存（使能键置位，失能键清除） | 按使能键后为 1
| logic.arm_stopped | 机械臂停止锁存 | 0
| logic.reverse | 机械臂方向：0 正向，1 反向（对应 LED_STATUS2） | 按需
临时测试 | miso_level | CSN 为高时 MISO 电平（临时代码，测完删除） | 1

## 3.2 Data Sampling

分组 | 表达式 | 看什么
NRF 发送 | tx_ok_count | 发送成功并收到小车应答，应持续上升（约每秒 100 次）
| tx_lost_count | 发出但小车没应答。持续上升说明手柄正常、小车没收到
| tx_timeout_count | 发送超时，应不涨。上涨多为模块供电或 CE 问题
摇杆 | forward | 前后摇杆，-1000～1000，推到底为 ±1000
| left | 左右摇杆，-1000～1000
按键 | debounce.stable | 去抖后的按键位图，按下对应位为 1
系统 | uwTick | 系统时间（ms），曲线回落说明手柄复位

# 4 在 Watched Data 里实时修改变量

在 Watched Data 里双击某个变量的 Value 格，输入新值后按回车，就会写进芯片。程序运行时如果不能修改，先按暂停，改完再按 F5 继续。

- 改的值只保存在芯片内存里，复位或重新上电后就恢复成代码里的初始值。调好的数值要写回代码再重新编译。
- 代码里用 #define 定义的常量（例如 REMOTE_ACTIVE_SOURCE、CHASSIS_GEAR1_MAX_RPM、IMU_YAW_SIGN、HEADING_KP_RPM_PER_DEG）不是变量，不能在 Ozone 里改，只能改代码重新编译。

## 4.1 小车：改了有用的变量

分组 | 表达式 | 改了有什么效果 | 注意
机械臂 | arm_cycle.current.joint[i] | 舵机立即转到这个角度，用来标定零位、方向和限位 | 全速跳过去，没有限速；先确认不会撞到东西
| arm_cycle.control.target.joint[i] | 机械臂按限速慢慢转到这个角度 | 只在已使能（E=1）时有效，未使能时每 20 ms 被改回当前角度
底盘 PID（fl/fr/rl/rr 各一组） | speed_pid_fl.Kp | 比例增益，下一个周期就生效，边看曲线边调 | 从小值开始加，调好后写回 SpeedPID_InitAll
| speed_pid_fl.Ki | 积分增益 | 同上
| speed_pid_fl.Kd | 微分增益 | 同上
| speed_pid_fl.MaxOut | PID 输出上限（0～1，对应 PWM 占空比） | 第一次调车可以先设成 0.3，限制最大功率
方向 | motor_fl.direction_sign | 电机转向，改成 1 或 -1 | 确认后写回 Motor_Init 的最后一个参数
| encode_fl.direction_sign | 编码器计数方向，改成 1 或 -1 | 电机正转时实测转速应为正
| encode_fl.count_per_rev | 输出轴一圈的计数，影响实测转速的大小 | 确认后写回 COUNT_PER_REV
遥控 | remote_input.selected | 切换遥控来源：1 手机，2 手柄。不用改代码重新烧录 | 切换后要重新“先失能再使能”；复位后恢复成 REMOTE_ACTIVE_SOURCE
| robot_cmd.gear | 直接设置挡位 1～3 | 超出 1～3 会出错，不要乱填

## 4.2 小车：不要改，或者改了没用的变量

分组 | 表达式 | 原因
安全 | robot_cmd.enabled | 强行改成 1 会跳过“先失能再使能”的上锁步骤，遥控 S1 正开着时车会直接动起来，不要改
| safety_input.active | 每 5 ms 按急停、驱动故障引脚和电池状态重新计算，改了马上被覆盖
每周期重算 | target_rpm_fl 等 | 底盘任务每 10 ms 根据遥控命令重新计算
| arm_cycle.pulse_us[i] | 每 20 ms 由当前角度换算出来，要改就改 arm_cycle.current.joint[i]
| 各种计数 | radio_rx_count、phone_rx_frames 等只用来观察

## 4.3 手柄

手柄的状态都由按键和摇杆决定，一般不需要在 Ozone 里改。调试时直接操作手柄，在 Watched Data 里观察即可。

# 5 建议的检查顺序

## 小车

1. reset_cause 不是 4，uwTick 曲线持续上升，没有反复复位。
2. safety_input.active 为 0；不为 0 时按位查急停、欠压和驱动故障。
3. 遥控计数在涨：手机看 phone_rx_frames，手柄看 radio_rx_count。
4. 先失能再使能后，robot_cmd.enabled 变成 1。
5. 推遥控，看机械臂的 arm_cycle.pulse_us[i] 或底盘的 target_rpm_* 是否跟着变化。
6. 底盘调 PID 时，把同一个轮子的目标转速和实测转速放在 Timeline 里对比。

## 手柄

1. calibrated、input_ok 为 1（上电时不要推摇杆）。
2. radio_ready 为 1。为 0 时先查模块方向、供电和是否发热。
3. tx_ok_count 持续上升、have_status 为 1，说明和小车通了；tx_lost_count 上升说明小车没应答，去查小车的 radio_ready。
4. 要用手柄控制小车，需要把小车代码 Core/Src/app_freertos.c 里的 REMOTE_ACTIVE_SOURCE 改成 REMOTE_SOURCE_HANDHELD。

# 6 注意

- phone_rx_bytes、phone_rx_frames、remote_diag、arm_pulse_diag 只存在于目前未提交的小车代码中；如果烧的是旧固件，Ozone 会提示找不到这些变量。
- miso_level 是手柄上的临时测试变量，NRF 调通后会删除。
- 舵机没有位置反馈，arm_cycle.current.joint[i] 是程序发出的命令角度，不是舵机实际角度。
