MIRYHANG/srm-2027-minibot/docs/上电调试日志.md

# 上电调试日志

## 2026-10-25 调试日志

今天调试机械臂，无底盘。一开始烧入代码，在ozone里修改arm_cycle.current.joint[idx]的角度值，
发现舵机可以正常转动，但是手柄失灵。鉴于避繁就简的原则，我们一致决定先用蓝牙调试，后续用手柄。

## 2026-10-26 调试日志

板子烧了，调试暂停

## 2026-10-27 调试日志

等待芯片送达中...同时调试手柄，发现插上jlink调试始终无法检测到nrf，经过一下午的测试发现是nrf焊接虚焊了，
等待全新模块送达中...成品模块供我调试，硬件队友重新购买nrf芯片自己焊接，然后再让我调试

## 2026-10-28 调试日志

等待芯片送达中...等待成品模块送达中...

## 2026-10-29 调试日志

成品模块早上送达，经过ozone测试，可以正常检测到该模块，并且按键消抖也没有问题，调试变量可以显示正确的值。
摇杆引脚配错了，adc检测方向写反了，最后都一一修改了，最终结论遥控板完全没有问题，下午主控芯片送达，重新焊接后
oled，电源adc也都没有问题，加上nrf模块发现可以与手柄连上了，我们无疑是兴奋的(

## 2026-10-30 调试日志

中午下课欣喜地前往实现室内，接上一个电机线后准备测试，然而在我接上电池后，在开关关闭的情况下主控冒烟了(悲)，
背上了“主控杀手”的罪名后赶回寝室把板子交给硬件修复，由于这次多买了芯片，很快修好了，重返实验室接上电机线，
通过遥控可以控制电机了，但是fl电机不受控制狂转，其余不转。通过经验判断肯定是编码器方向配置反了，改好之后却发现
所有的都不转了。经过一下午的测试发现是fl驱动芯片的引脚每次遥控都会被强行拉低到0，可能是之前烧主控的时候损坏了，
由于还得回寝室取芯片修路太远了，我决定把fl电机拔掉测试其他三个，结果连接不上小车，然后才想起来小车有一个安全代码，
任一驱动nFault低电平强行急停小车，必须等待nFault正常才能使能小车。于是我屏蔽了这个检测，重新调试，改完编码器方向后
三个轮子可以正常转了，然而好景不长，不知为何出现了神秘复位问题，我们苦思冥想不得其解，最后在范组长的指导下回到寝室修好了
板子，并且把驱动芯片换成新的。

## 2026-10-31 调试日志

一大早就前往实验室，万幸板子不再出现复位问题，接上fl也可以正常转动了，下地测试发现移动方向不对，修正电机方向代码后
小车可以正常运行了，修改速度过慢问题后就优哉游哉地等待结构过来装机械臂。晚上装好后，由于时间紧迫，没考虑堵转问题，直接六个舵机一起上电了
不出意外的出意外了，舵机复位到一个神秘的位置，导致可能是三个或者四个舵机堵了，直接给板子干复位了，又换了降压芯片以及上拉电阻
却无济于事，整队陷入绝望，好在经过我和结构的鼓励后硬件重新振作，回去把所有的降压部分都换了一遍，又飞线把3.3v接到复位按键
居然修好了，事不宜迟我们通宵调试，这次一个一个测试舵机，但是还是有一个舵机不幸的冒烟阵亡了，可能是在实验室就坏了，好在剩下五个没事，
到了三点半整车终于可以正常运作了，但是大家实在是困的不行了，去睡觉了，没来得及添加夹矿预设位姿以及装矿预设(原因是必须要连接jlink在ozone
上看舵机角度才能设置位姿，然而不知道为什么，只要接jlink一段时间就会复位，jlink甚至都没接3v3,为了赶进度以及整车完整性，只能被迫放弃预设)
