MIRYHANG/srm-2027-minibot/Core/Src/main.c

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
/* Includes ------------------------------------------------------------------*/
#include "main.h"
#include "cmsis_os.h"
#include "i2c.h"
#include "iwdg.h"
#include "spi.h"
#include "tim.h"
#include "usart.h"
#include "gpio.h"

/* USER CODE BEGIN Includes */
#include "safety.h"
/* USER CODE END Includes */


/* USER CODE BEGIN PV */
// 上电时的 RCC->CSR，保存复位原因（看门狗、上电、按键等），供调试和 OLED 显示
volatile uint32_t g_reset_flags = 0U;

// 复位计数，放在 .noinit 段，复位后保留；断电后 magic 对不上，从零开始
// 不接调试器跑一段时间，再连上调试器（不要复位）查看
#define RESET_STATS_MAGIC 0x52535431U
typedef struct
{
  uint32_t magic;
  uint32_t total; // 本次上电以来的复位次数，不含上电本身
  uint32_t pin;   // 只有 PIN：复位脚被外部拉低
  uint32_t power; // BOR：供电电压掉下去
  uint32_t iwdg;  // 看门狗：程序卡住或出错
  uint32_t soft;  // 软件复位：一般是调试器发出的
  uint32_t other;
} ResetStats_t;
__attribute__((section(".noinit"))) volatile ResetStats_t g_reset_stats;
/* USER CODE END PV */

void SystemClock_Config(void);
void MX_FREERTOS_Init(void);
/**
  * @brief  The application entry point.
  * @retval int
  */
int main(void)
{

  /* USER CODE BEGIN 1 */
  // 复位标志要在其他代码之前读取，读完清除，否则下次复位时会和旧标志叠在一起
  g_reset_flags = RCC->CSR;
  __HAL_RCC_CLEAR_RESET_FLAGS();

  if (g_reset_stats.magic != RESET_STATS_MAGIC)
  {
    g_reset_stats = (ResetStats_t){.magic = RESET_STATS_MAGIC};
  }
  else
  {
    g_reset_stats.total++;
    if ((g_reset_flags & RCC_CSR_IWDGRSTF) != 0U)
    {
      g_reset_stats.iwdg++;
    }
    else if ((g_reset_flags & RCC_CSR_SFTRSTF) != 0U)
    {
      g_reset_stats.soft++;
    }
    else if ((g_reset_flags & RCC_CSR_BORRSTF) != 0U)
    {
      g_reset_stats.power++;
    }
    else if ((g_reset_flags & RCC_CSR_PINRSTF) != 0U)
    {
      g_reset_stats.pin++;
    }
    else
    {
      g_reset_stats.other++;
    }
  }
  /* USER CODE END 1 */

  /* MCU Configuration--------------------------------------------------------*/

  /* Reset of all peripherals, Initializes the Flash interface and the Systick. */
  HAL_Init();

  /* Configure the system clock */
  SystemClock_Config();

  /* USER CODE BEGIN SysInit */
  __HAL_DBGMCU_FREEZE_TIM1();
  __HAL_DBGMCU_FREEZE_IWDG();
  /* USER CODE END SysInit */

  /* Initialize all configured peripherals */
  MX_GPIO_Init();
  MX_TIM3_Init();
  MX_TIM1_Init();
  MX_TIM2_Init();
  MX_TIM4_Init();
  MX_TIM5_Init();
  MX_SPI1_Init();
  MX_TIM8_Init();
  MX_TIM15_Init();
  MX_USART2_UART_Init();
  MX_I2C2_Init();
  MX_IWDG_Init();
  /* Call init function for freertos objects (in cmsis_os2.c) */
  MX_FREERTOS_Init();

  /* Start scheduler */
  osKernelStart();

  /* We should never get here as control is now taken by the scheduler */

  /* Infinite loop */
  /* USER CODE BEGIN WHILE */
  while (1)
  {
    /* USER CODE END WHILE */

    /* USER CODE BEGIN 3 */
  }
  /* USER CODE END 3 */
}

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
/**
  * @brief  Period elapsed callback in non blocking mode
  * @note   This function is called  when TIM17 interrupt took place, inside
  * HAL_TIM_IRQHandler(). It makes a direct call to HAL_IncTick() to increment
  * a global variable "uwTick" used as application time base.
  * @param  htim : TIM handle
  * @retval None
  */
void HAL_TIM_PeriodElapsedCallback(TIM_HandleTypeDef *htim)
{
  if (htim->Instance == TIM17)
  {
    HAL_IncTick();
  }
}

/**
  * @brief  This function is executed in case of error occurrence.
  * @retval None
  */
void Error_Handler(void)
{
  /* USER CODE BEGIN Error_Handler_Debug */
  /* User can add his own implementation to report the HAL error return state */
  __disable_irq();
  Safety_EmergencyStop();
  while (1)
  {
  }
  /* USER CODE END Error_Handler_Debug */
}
#ifdef USE_FULL_ASSERT
/**
  * @brief  Reports the name of the source file and the source line number
  *         where the assert_param error has occurred.
  * @param  file: pointer to the source file name
  * @param  line: assert_param error line source number
  * @retval None
  */
void assert_failed(uint8_t *file, uint32_t line)
{
  /* USER CODE BEGIN 6 */
  /* User can add his own implementation to report the file name and line number,
     ex: printf("Wrong parameters value: file %s on line %d\r\n", file, line) */
  /* USER CODE END 6 */
}
#endif /* USE_FULL_ASSERT */
