MIRYHANG/srm-2027-minibot/XiaoSai.ioc

Mcu.UserName=STM32G474VETx
PA0.GPIO_Label=ENC_RR_A
PA0.Signal=S_TIM5_CH1
PA1.GPIO_Label=ENC_RR_B
PA1.Signal=S_TIM5_CH2
PA10.GPIO_Label=NRF_CSN
PA10.Signal=GPIO_Output
PA11.GPIO_Label=NRF_CE
PA11.Signal=GPIO_Output
PA13.Signal=SYS_JTMS-SWDIO
PA14.Signal=SYS_JTCK-SWCLK
PA2.Signal=USART2_TX
PA3.Signal=USART2_RX
PA4.GPIO_Label=ENC_FR_B
PA4.Signal=S_TIM3_CH2
PA6.GPIO_Label=ENC_FR_A
PA6.Signal=S_TIM3_CH1
PA8.GPIO_Label=OLED_INA226_SDA
PA8.Signal=I2C2_SDA
PA9.GPIO_Label=OLED_INA226_SCL
PA9.Signal=I2C2_SCL
PB1.GPIO_Label=BMI_INT1
PB1.Signal=GPXTI1
PB14.GPIO_Label=Servo_PWM_5
PB14.Signal=S_TIM15_CH1
PB15.GPIO_Label=Servo_PWM_6
PB15.Signal=S_TIM15_CH2
PB3.GPIO_Label=BMI088_NRF_SCK
PB3.Signal=SPI1_SCK
PB4.GPIO_Label=BMI088_NRF_MISO
PB4.Signal=SPI1_MISO
PB5.GPIO_Label=BMI088_NRF_MOSI
PB5.Signal=SPI1_MOSI
PC0.GPIO_Label=MOTOR_FL_PWM
PC0.Signal=S_TIM1_CH1
PC1.GPIO_Label=MOTOR_FR_PWM
PC1.Signal=S_TIM1_CH2
PC10.GPIO_Label=BMI_ACC_CS
PC10.Signal=GPIO_Output
PC11.GPIO_Label=BMI_GYRO_CS
PC11.Signal=GPIO_Output
PC2.GPIO_Label=MOTOR_RL_PWM
PC2.Signal=S_TIM1_CH3
PC3.GPIO_Label=MOTOR_RR_PWM
PC3.Signal=S_TIM1_CH4
PC4.GPIO_Label=BMI_INT3
PC4.Signal=GPXTI4
PC6.GPIO_Label=Servo_PWM_1
PC6.Signal=S_TIM8_CH1
PC7.GPIO_Label=Servo_PWM_2
PC7.Signal=S_TIM8_CH2
PC8.GPIO_Label=Servo_PWM_3
PC8.Signal=S_TIM8_CH3
PC9.GPIO_Label=Servo_PWM_4
PC9.Signal=S_TIM8_CH4
PD12.GPIO_Label=ENC_FL_A
PD12.Signal=S_TIM4_CH1
PD13.GPIO_Label=ENC_FL_B
PD13.Signal=S_TIM4_CH2
PD3.GPIO_Label=ENC_RL_A
PD3.Signal=S_TIM2_CH1
PD4.GPIO_Label=ENC_RL_B
PD4.Signal=S_TIM2_CH2
PE0.GPIO_Label=NRF_IRQ
PE0.Signal=GPXTI0
PE10.GPIO_Label=ESTOPN
PE10.Signal=GPIO_Input
PE12.GPIO_Label=FL_FAULT
PE12.Signal=GPIO_Input
PE13.GPIO_Label=FR_FAULT
PE13.Signal=GPIO_Input
PE14.GPIO_Label=RL_FAULT
PE14.Signal=GPIO_Input
PE15.GPIO_Label=RR_FAULT
PE15.Signal=GPIO_Input
PE2.GPIO_Label=MOTOR_FL_DIR
PE2.Signal=GPIO_Output
PE3.GPIO_Label=MOTOR_FR_DIR
PE3.Signal=GPIO_Output
PE4.GPIO_Label=MOTOR_RL_DIR
PE4.Signal=GPIO_Output
PE5.GPIO_Label=MOTOR_RR_DIR
PE5.Signal=GPIO_Output
PE7.GPIO_Label=LED_RUN
PE7.Signal=GPIO_Output
PE8.GPIO_Label=LED_LINK
PE8.Signal=GPIO_Output
PE9.GPIO_Label=LED_FAULT
PE9.Signal=GPIO_Output
PF0-OSC_IN.Signal=RCC_OSC_IN
PF1-OSC_OUT.Signal=RCC_OSC_OUT
