MIRYHANG/srm-2027-minibot/Test/test_power_display.c

//
// Created by YZH on 2026/10/5.
//
#include <assert.h>
#include <math.h>
#include <stdbool.h>
#include <stddef.h>
#include <stdio.h>
#include <string.h>

#include "power_display.h"

static PowerDisplayLine_t lines[POWER_DISPLAY_LINES];

static void Format(float v, float i, float p, bool valid, ResetCause_t cause)
{
    Ina226Reading_t reading = {.bus_v = v, .current_a = i, .power_w = p};

    // 先填满垃圾，确认每一行都被重写并正确结尾
    memset(lines, 'Z', sizeof(lines));
    PowerDisplay_Format(&reading, valid, cause, lines);

    for (size_t idx = 0U; idx < POWER_DISPLAY_LINES; idx++)
    {
        assert(strlen(lines[idx]) <= POWER_DISPLAY_COLS);
    }
}

static void TestValidReading(void)
{
    Format(12.34f, 1.25f, 15.42f, true, RESET_CAUSE_POWER);

    assert(strcmp(lines[0], "XIAOSAI POWER") == 0);
    assert(strcmp(lines[1], "") == 0);
    assert(strcmp(lines[2], "U   12.34 V") == 0);
    assert(strcmp(lines[3], "I    1.25 A") == 0);
    assert(strcmp(lines[4], "P    15.4 W") == 0);
    assert(strcmp(lines[5], "") == 0);
    assert(strcmp(lines[6], "INA226 OK") == 0);
    assert(strcmp(lines[7], "RST POWER") == 0);
}

static void TestRoundingAndSign(void)
{
    // 四舍五入、进位、负数
    Format(0.0f, -1.25f, -1677.7f, true, RESET_CAUSE_POWER);
    assert(strcmp(lines[2], "U    0.00 V") == 0);
    assert(strcmp(lines[3], "I   -1.25 A") == 0);
    assert(strcmp(lines[4], "P -1677.7 W") == 0);

    Format(9.996f, 0.004f, 99.96f, true, RESET_CAUSE_POWER);
    assert(strcmp(lines[2], "U   10.00 V") == 0);
    assert(strcmp(lines[3], "I    0.00 A") == 0);
    assert(strcmp(lines[4], "P   100.0 W") == 0);

    // 四舍五入后为 0 的负数不显示负号
    Format(40.96f, -0.004f, -0.04f, true, RESET_CAUSE_POWER);
    assert(strcmp(lines[2], "U   40.96 V") == 0);
    assert(strcmp(lines[3], "I    0.00 A") == 0);
    assert(strcmp(lines[4], "P     0.0 W") == 0);
}

static void TestInvalidValues(void)
{
    // 读数无效：数值显示横线
    Format(12.34f, 1.25f, 15.42f, false, RESET_CAUSE_IWDG);
    assert(strcmp(lines[2], "U   --.-- V") == 0);
    assert(strcmp(lines[3], "I   --.-- A") == 0);
    assert(strcmp(lines[4], "P    --.- W") == 0);
    assert(strcmp(lines[6], "INA226 ERROR") == 0);
    assert(strcmp(lines[7], "RST IWDG") == 0);

    // 单个数值异常：只有这一项显示横线
    Format(NAN, INFINITY, 12345678.0f, true, RESET_CAUSE_POWER);
    assert(strcmp(lines[2], "U   --.-- V") == 0);
    assert(strcmp(lines[3], "I   --.-- A") == 0);
    assert(strcmp(lines[4], "P    --.- W") == 0);
    assert(strcmp(lines[6], "INA226 OK") == 0);

    // 放不进 7 个字符：显示横线
    Format(-99999.9f, 0.0f, 0.0f, true, RESET_CAUSE_POWER);
    assert(strcmp(lines[2], "U   --.-- V") == 0);

    // 数值本身不大，但加上负号后是 8 个字符，也放不下
    Format(-9999.99f, 9999.99f, 0.0f, true, RESET_CAUSE_POWER);
    assert(strcmp(lines[2], "U   --.-- V") == 0);
    assert(strcmp(lines[3], "I 9999.99 A") == 0);

    // reading 为 NULL 视为无效
    memset(lines, 'Z', sizeof(lines));
    PowerDisplay_Format(NULL, true, RESET_CAUSE_PIN, lines);
    assert(strcmp(lines[2], "U   --.-- V") == 0);
    assert(strcmp(lines[6], "INA226 ERROR") == 0);
    assert(strcmp(lines[7], "RST PIN") == 0);

    PowerDisplay_Format(NULL, false, RESET_CAUSE_PIN, NULL);
}

static void TestResetCauses(void)
{
    static const struct
    {
        ResetCause_t cause;
        const char *text;
    } cases[] = {
        {RESET_CAUSE_UNKNOWN, "RST ?"},
        {RESET_CAUSE_POWER, "RST POWER"},
        {RESET_CAUSE_PIN, "RST PIN"},
        {RESET_CAUSE_SOFTWARE, "RST SOFT"},
        {RESET_CAUSE_IWDG, "RST IWDG"},
        {RESET_CAUSE_WWDG, "RST WWDG"},
        {RESET_CAUSE_LOW_POWER, "RST LOWPWR"},
        {(ResetCause_t)99, "RST ?"},
    };

    for (size_t idx = 0U; idx < sizeof(cases) / sizeof(cases[0]); idx++)
    {
        Format(12.0f, 1.0f, 12.0f, true, cases[idx].cause);
        assert(strcmp(lines[7], cases[idx].text) == 0);
    }
}

static void TestBatteryLine(void)
{
    PowerDisplayLine_t line;

    PowerDisplay_FormatBattery(BATTERY_OK, 75U, line);
    assert(strcmp(line, "BAT  75% OK") == 0);

    PowerDisplay_FormatBattery(BATTERY_OK, 100U, line);
    assert(strcmp(line, "BAT 100% OK") == 0);

    PowerDisplay_FormatBattery(BATTERY_LOW, 5U, line);
    assert(strcmp(line, "BAT   5% LOW") == 0);

    PowerDisplay_FormatBattery(BATTERY_CRITICAL, 0U, line);
    assert(strcmp(line, "BAT   0% STOP") == 0);

    // 没有读数时电量显示横线；超过 100 按 100 显示
    PowerDisplay_FormatBattery(BATTERY_UNKNOWN, 50U, line);
    assert(strcmp(line, "BAT   -% ?") == 0);
    PowerDisplay_FormatBattery(BATTERY_OK, 250U, line);
    assert(strcmp(line, "BAT 100% OK") == 0);

    PowerDisplay_FormatBattery(BATTERY_OK, 50U, NULL);
}

static void TestRemoteLine(void)
{
    PowerDisplayLine_t line;

    PowerDisplayRemote_t remote = {
        .rx_bytes = 1123U,
        .rx_frames = 45U,
        .online = true,
        .s1 = true,
        .s2 = false,
        .safety = 0x10U,
        .enabled = false
    };
    PowerDisplay_FormatRemote(&remote, line);
    assert(strcmp(line, "R123 F045 S10 X10 E0") == 0);

    // 离线时不显示开关状态
    remote.online = false;
    remote.safety = 0x00U;
    remote.enabled = true;
    PowerDisplay_FormatRemote(&remote, line);
    assert(strcmp(line, "R123 F045 S-- X00 E1") == 0);

    remote.safety = 0x3FU;
    PowerDisplay_FormatRemote(&remote, line);
    assert(strcmp(line, "R123 F045 S-- X3F E1") == 0);

    PowerDisplay_FormatRemote(NULL, line);
    assert(strcmp(line, "") == 0);
    PowerDisplay_FormatRemote(&remote, NULL);
}

static void TestArmLine(void)
{
    PowerDisplayLine_t line;

    PowerDisplayRemote_t remote = {
        .arm_joint = 1U,
        .arm_jog = 1.0f,
        .arm_enabled = true
    };
    PowerDisplay_FormatArm(&remote, 1500U, line);
    assert(strcmp(line, "J1 G+100 P1500 A1") == 0);

    remote.arm_joint = 6U;
    remote.arm_jog = -0.456f;
    remote.arm_enabled = false;
    PowerDisplay_FormatArm(&remote, 833U, line);
    assert(strcmp(line, "J6 G-046 P0833 A0") == 0);

    remote.arm_jog = 0.0f;
    PowerDisplay_FormatArm(&remote, 2500U, line);
    assert(strcmp(line, "J6 G+000 P2500 A0") == 0);

    // 非法 jog 和关节显示占位符
    remote.arm_joint = 0U;
    remote.arm_jog = NAN;
    PowerDisplay_FormatArm(&remote, 2500U, line);
    assert(strcmp(line, "J? G --- P2500 A0") == 0);

    PowerDisplay_FormatArm(NULL, 0U, line);
    assert(strcmp(line, "") == 0);
    PowerDisplay_FormatArm(&remote, 0U, NULL);
}

int main(void)
{
    TestValidReading();
    TestRoundingAndSign();
    TestInvalidValues();
    TestResetCauses();

    TestBatteryLine();
    TestRemoteLine();
    TestArmLine();

    puts("Power display tests passed");
    return 0;
}
