MIRYHANG/srm-2027-minibot/(commit log)

2026-09-25 第一次提交，仅配置pwm定时器和编码器定时器以及调试用串口，其余暂未配置
2026-09-25 第一次提交，仅配置pwm定时器和编码器定时器，以及串口调试接口
2026-09-25 加入pid的头文件，借鉴湖南大学开源
2026-09-25 新增controller.c文件，写入PID优化算法以及初始化
2026-09-25 补齐controller.c，pid算法整体外部接口以及优化部分数据类型问题
2026-09-25 优化了static静态变量问题，不需要保存每次数值，另外对init函数进行保护措施
2026-09-25 添加编码器的驱动代码，但还没有写入电机参数
2026-09-25 添加电机驱动代码，并在freertos文件加入motor结构体变量
2026-09-25 添加启动代码，并对freertos的启动函数部分进行封装
2026-09-26 添加编码器启动代码以及封装，但init函数的参数还没有测量，暂时填1，1，0占位
2026-09-26 添加每10ms测量编码器的值
2026-09-26 修改了task名称，改用osDelayUntil精确计时
2026-09-26 初始化速度环pid
2026-09-26 新增PIDupdate，并将所有更新函数封装
2026-09-26 添加了麦轮解算的雏形代码
2026-09-26 添加测试解算公式是否正确的文件，不加入编译
2026-09-26 在Free RTOS中加入麦轮的更新函数，包括其封装
2026-09-26 协议层初具雏形
2026-09-27 实现遥控来源切换与超时归零
2026-09-27 添加测试
2026-09-27 将SRM的解析协议复制进工程
2026-09-27 对校内赛开源协议解析进行转换，便于后续接口调用，另外外加其余外设配置
2026-09-28 添加处理手机遥控字节函数
2026-09-28 添加蓝牙串口的队列创建函数
2026-09-28 完成串口回调函数
2026-09-28 修改了一个小bug，防止’||‘导致的短路问题
2026-09-28 添加取出数据的函数，供后续任务调用
2026-09-28 添加错误回调函数，查询是否异常函数，恢复接收函数
2026-09-28 添加一整套初始化以及数据解析更新函数的封装，并且在主任务里启用
2026-09-28 添加数据帧解析后传递给底盘以控制其运动的函数
2026-09-29 添加底盘急停函数
2026-09-29 停机期间也要更新编码器
2026-09-29 添加舵机初始化函数
2026-09-29 添加设置舵机pwm函数
2026-09-29 添加舵机上电启动函数
2026-09-29 添加舵机停机函数
2026-09-29 添加设置舵机位置的函数
2026-09-30 添加机械臂检查函数，防止数值不合法
2026-09-30 加入缓存，收到合法姿态就保存
2026-09-30 添加读取目标和清除目标函数
2026-10-01 添加机械臂标定模块的头文件，同时修改了pose头文件
2026-10-01 添加机械臂关节标定表和读取函数
2026-10-01 修正了arm_pose的joint逻辑问题，优化if语句，改成for循环遍历
2026-10-01 添加关节限位函数的实现
2026-10-01 修正for的逻辑小问题，改成判断calib
2026-10-02 完成关节目标值换算函数
2026-10-02 使用指定标定项换算脉宽
2026-10-02 优化掉函数里的重复公式
2026-10-02 添加测试代码并成功通过测试
2026-10-02 封装限幅函数，代码整洁度提升，另外根据手册修改机械臂关节角度限幅
2026-10-03 添加看门狗和急停措施
2026-10-03 添加机械臂位姿计算函数
2026-10-03 添加机械臂单步移动测试代码，并添加纯软件测试日志
2026-10-04 从原有的‘收到第一帧有效数据后车会立刻继续运动’改为‘每次遥控状态被清空后，必须先收到一帧 enabled == false 的有效帧，’
2026-10-04 新增机械臂遥控命令结构和校验
2026-10-04 实现手机遥控的机械臂关节选择和命令映射
2026-10-04 添加测试代码
2026-10-04 新增任务心跳文件，检测任务是否运行超时，并重新规划FreeRTOS任务调度
2026-10-04 添加测试代码，更新调试日志
2026-10-05 任务心跳超时后底盘立即停车，不再按遥控命令继续运动；删掉 PhoneRemote_Update 里重复的 return
2026-10-05 feat: 新增 ArmControl_Update，把机械臂遥控命令换算成目标位姿
    jog 以当前位姿为基准，松手即停；预设只改 J1~J5，夹爪只由 X/Y 控制；非法输入时 control 保持不变。新增 test_arm_control，7 个主机测试全部通过。
2026-10-05 更新调试日志
2026-10-05 feat: ArmTask 接上舵机输出，失联或停机时机械臂当场停住
    新增 arm_cycle：上电以 STOW 初始化后再启动 PWM；每周期更新目标、限速逼近、换算脉宽，失败时保持上一次脉宽；未使能或停机时目标拉回当前位置。main 上电读取复位标志 g_reset_flags。新增 test_arm_cycle，8 个主机测试全部通过。
2026-10-05 feat: 新增 INA226 功率采样，接入 SensorTask
    新增 I2C 总线接口及 HAL 实现（超时 10 ms）；INA226 驱动：芯片 ID 校验、地址自动扫描、配置回读、电压电流功率换算（分流电阻 2 mΩ）。SensorTask 每 100 ms 读取一次，失败时每 1 s 重试，不影响行驶。新增 test_ina226，9 个主机测试全部通过。
2026-10-05 chore: 忽略主机测试生成的 exe，并移出仓库
2026-10-05 添加字库
2026-10-05 feat: 新增 SSD1306 OLED 功率显示，接入 SensorTask
    SSD1306 驱动只刷新变化的页，每次传输 16 字节；显示格式化不依赖 printf。OLED 每 500 ms 显示电压、电流、功率、INA226 状态和复位原因，失败时每 1 s 重试，不影响行驶。新增 test_ssd1306、test_power_display，11 个主机测试全部通过。
2026-10-05 chore: 忽略 exe 文件并移出仓库
2026-10-05 feat: 新增电机台架测试工程 bringup/TestMotor
2026-10-06 修改了servo.c的注释以及一些小问题，防止代码只有上帝看得懂
2026-10-06 删除ArmCalib_ToPulse，统一使用ArmCalib_ToPulseWithCalib
2026-10-07 添加部分注释
2026-10-07 新增 OLED 字库显示测试工程 bringup/TestOLED
2026-10-07 仿照湖南大学开源，添加机器人命令控制结构体
2026-10-07 修改了部分文件依赖以及更新结构体名称
2026-10-07 更新测试文件的头文件依赖以及结构体
2026-10-08 修正了cycle函数的头文件依赖，以及更新测试文件
2026-10-08 新增临时函数 ArmCmd_FromRemote 把遥控命令转换为机械臂命令
2026-10-08 新增急停与驱动故障输入去抖模块
2026-10-08 删除临时想出的OLED显示方案，OLED专门显示电源功率
2026-10-08 复位逻辑改由后续函数负责，OperatorDisabled不再需要，RobotCmd要区分遥控掉线和操作手关闭使能，而GetSafe对两者都返回enabled=false，无法区分，因此新增只判断在线的GetLatest
2026-10-08 添加文档说明
2026-10-09 新增 RobotCmd 统一管理使能、急停和挡位，以及状态LED
2026-10-10 添加麦轮混合归一化函数
2026-10-10 添加底盘命令控制底盘挡位限速的文件
2026-10-10 把代码接入freertos文件
2026-10-11 添加加速度斜坡函数，防止速度过冲
2026-10-11 夹爪改成按住点动，删除一键夹取松开
2026-10-11 添加自制手柄工程
2026-10-11 添加遥控NRF驱动，遥控端和主控共用驱动代码
2026-10-11 添加头文件以及crc校验函数实现
2026-10-11 添加编码函数和解码函数
2026-10-11 添加小车状态解码编码函数
2026-10-11 解码时 0x80 按负数处理
2026-10-11 添加按键逻辑初始化函数
2026-10-12 加入两个锁存器函数
2026-10-12 修改了UpdateArmStop里面if判断的bug
2026-10-12 完成手柄按键逻辑以及LED显示
2026-10-12 添加按键消抖死区换算中点标定
2026-10-20 添加bmi088头文件代码
2026-10-21 添加spi互斥锁和bmi实现
2026-10-22 添加按键扫描和摇杆ADC DMA采样
2026-10-22 添加中点标定和读取按键摇杆函数
2026-10-22 添加输入健康检查、控制指令发送和 LED 控制
2026-10-23 gitignore 覆盖子工程构建目录，忽略 tmp、压缩包和覆盖率文件
2026-10-23 手柄喂狗补上 iwdg.h，输入异常时两灯交替闪
2026-10-23 NRF SPI 出错后跳过后续读写，直到重新配置时清除
2026-10-23 添加调试变量
2026-10-23 手柄主循环改为调用 HhApp，删除链路测试代码
2026-10-24 添加看门狗
2026-10-24 手柄链路计数器移到 hh_app 并累加，超时判断改用已有宏
2026-10-24 主控切换到手柄遥控，NRF 掉配置后自动重新配置
2026-10-24 删除底盘加速斜坡，摇杆回中时目标转速立即归零
2026-10-24 遥控来源切回手机蓝牙
2026-10-24 添加电池欠压保护和 BMI088 航向保持
    - 3S 电池低于 10.5 V 报警、低于 9.9 V 失能，带滤波、回差和 2 s 确认
    - 欠压作为安全输入，和急停走同一路径；OLED 第 6 行显示电量和状态
    - 新增 ImuTask，200 Hz 读 BMI088，上电静止 2 s 标定零偏后积分航向
    - 平移且未按自转键时用 PD 保持航向，增益暂为 0，待确认 IMU 方向后再调
2026-10-28 手柄摇杆 ADC 引脚改为 PA1/PA2，与 PCB 一致
    原配置为 PA0/PA1，实际摇杆 X 接 PA1、Y 接 PA2，导致前后推无反应、
    PA0 悬空读到上一路的残留电压。同步修改 CubeMX 工程。
2026-10-28 I2C 总线忙时直接返回失败，避免看门狗反复复位
    总线被拉死时 HAL 固定等待 BUSY 25 ms，不受传入的超时控制，
    SensorTask 扫描 INA226 地址超过 400 ms 心跳期限，整车被看门狗复位。
2026-10-28 急停改为 PE10 接地有效
    急停按下时 PE10 接地读到低电平；未接急停或松开时由上拉读到高电平，
    台架测试不接急停也能使能。注意急停线断开时不会触发急停。
2026-10-28 OLED 显示遥控和机械臂诊断
    第 1 行显示选中关节、jog、脉宽和机械臂使能（J G P A），
    第 2 行显示收到的字节数、帧数、S1/S2、安全输入和整车使能（R F S X E），
    不接调试器也能判断遥控卡在哪一步。
2026-10-28 手柄摇杆 X 轴取反，往左推 left 为正
    协议规定 left 正数向左，实测往左推为负，STICK_X_INVERT 改为 true。
2026-10-29 删除 BMI088 驱动、航向保持和 IMU 任务
    BMI088 已从板上拆下，暂不使用 IMU。
    SPI1 只剩 NRF24 一个设备，去掉共用互斥锁。
    片选和中断引脚的 CubeMX 配置保留。
2026-11-02 手柄引脚改到实物：LED_STATUS1 PB7、LED_STATUS2 PB6、JOY_BTN PA9
2026-11-02 新增复位计数，放在 .noinit 段，按原因累计复位次数
2026-11-02 实车调试：遥控改用手柄，屏蔽驱动故障检测，修正电机和编码器方向
    - 驱动 nOL 接地导致开路检测误报，暂时屏蔽四路 nFAULT
    - 编码器每圈 1321 计数，四轮方向分别配置；FR、RL 电机方向取反
    - 四轮速度 PI 参数，挡位转速 200/250/300 rpm
    - 机械臂 J1～J5 限位放开到 0～180°
2026-11-02 新增小车和手柄的 Ozone 工程，预置调试观察变量
2026-11-02 删除代码中的 TODO 注释，机械臂限位注释改为当前做法
2026-11-02 README 按当前代码重写，新增一键运行单元测试脚本
    - README 补充进度、任务结构、安全机制、手柄操作、引脚、实车参数、临时措施和已知问题
    - 旧的开发记录保留在 README 末尾
    - 架构说明标注已过时
    - 加入 Ozone 调试变量清单和上电调试日志
    - 忽略 LibreOffice 锁文件
2026-11-02 上电调试日志整理格式；README 按调试日志更新进度和已知问题
2026-11-02 从仓库移除 Ozone 调试变量清单
