MIRYHANG/srm-2027-minibot/(notices)

Notices in the files:
bringup/TestOLED/Core/Inc/main.h:
Copyright (c) 2026 STMicroelectronics.
All rights reserved.
This software is licensed under terms that can be found in the LICENSE file
